MaverickUK/FDDSynthPro/docs/config.md

# The settings file

`/FDDSYNTH.CFG` on the SD card holds what the drive remembers across power-off, and how it sits on the cable. It's plain text, one `key=value` a line. The drive writes it a few seconds after you change the disk, the pack or the volume, so those three look after themselves. Edit the file on a computer to set the rest.

A damaged or missing file never stops the drive starting: an unknown line is ignored, and a bad value keeps the default.

```
last0=GAMES.IMG
pack=Recorded
volume=75
interface=ibmpc
cable=twisted
drive=a
```

| Key | Values | Default | |
|---|---|---|---|
| `device0` | a file name on the card | not set | **The disk to start with, every time.** Set it by hand; the drive never changes it. Not set, it starts with `last0` |
| `device1` | a file name on the card | not set | The same for the second drive, with two drives |
| `last0` | a file name on the card | the first | The disk that was in. The drive keeps this one up to date as you choose disks |
| `last1` | a file name on the card | the second | The second drive's, with two drives |
| `pack` | a folder under `/samples` | the first | The sample pack |
| `volume` | 0–100 | 75 | |
| `interface` | `ibmpc`, `shugart`, `amiga` | `ibmpc` | What the host expects on the cable |
| `cable` | `twisted`, `straight` | `twisted` | `ibmpc` only: is there a twist between the host and the drive? |
| `drive` | `a`, `b` or `a,b` (`ibmpc`); one or two of `ds0`, `ds1`, `ds2` (`shugart`); `df0`, `df1` or `df0,df1` (`amiga`) | `a` | Which drive this is: a real drive's select jumper. Two make it two drives |
| `pin02` | `nc`, `chg` | `nc` | `chg` drives DISK CHANGE on floppy pin 2 (Shugart and Amiga), after the carrier's rework ([wiring.md](wiring.md#pin-2-for-shugart-and-amiga-hosts-a-rework)) |

The drive reads `interface`, `cable` and `drive` at power-on. The console's `s` shows the ones in use.

**Changing a setting without taking the card out:** on the USB console, type `e`, then the setting (`interface=shugart`, or `device0 = GAMES.IMG`), then Enter. The drive writes it to the card at once, if the host isn't using the drive, and prints the file as it now is (`CONFIG` lines); a key it doesn't know, or a value it can't take, is refused and changes nothing. Then `!` restarts the drive with it. The drive's own `last0`, `pack` and `volume` follow the drive, as always.

**Drives count from 0**, as on HDDSynthPro (`device0`, `device1`) and on Shugart and Amiga cables (DS0, DF0): device 0 is the first drive `drive` names, device 1 the second. With `drive=a,b` they're A: and B:; with `drive=b` alone, device 0 is B:.

**Before 0.20.0** these were `image`, `image2`, `last` and `last2`. A file with the old names still works, and the drive writes them under the new names when it next saves. If a file has both, the new name counts.

## Two drives

`drive=a,b` (or two Shugart units, `drive=ds0,ds1`) makes the emulator both drives on the cable, each with its own disk, head and motor. With a PC that's A: and B:, and `COPY A:*.* B:` works as it would with two real drives. Each starts with its own disk (`device0`, `device1`) if set, else the disk that was in (`last0`, `last1`); with neither, the card's first two images.

- **The front panel** has a home screen for each, titled with its letter (`A: GAMES.IMG`). The action button goes from A's to B's, then on to the head trace. Choosing a disk, or a long press to eject, acts on the drive whose home screen was last shown.
- **The console's** `i`, `[`, `]` and `d` act on one drive: `1` or `2` chooses it. `s` reports the second drive's state with a `2` on each name (`cyl2`, `disk2`, `ready2`...).
- **The same image in both** is read-only in the second: two drives writing one file would each overwrite the other's changes.
- **The sound** is one mechanism: the motor runs while either drive's does, and you hear both drives' steps.
- Each drive keeps its own disk in PSRAM (1.44 MB each, of 8 MB) and its own cylinder buffer in RAM.

## Choosing the drive select

These do what the DS jumpers do on a real drive, and what the jumpers and FlashFloppy's `interface` setting do on a GoTek.

**An IBM PC** drives each drive on a pair of lines: select with motor. Drive A is on pins 14 and 10, drive B on 12 and 16. On a PC's cable the drive on the end connector, past the twist, sees A's lines on 12 and 16, so a PC drive is always jumpered for 12/16 and the cable decides whether it's A or B.

| Where the drive is | `cable` | `drive=a` answers on | `drive=b` answers on |
|---|---|---|---|
| Past the twist (the end of a PC cable) | `twisted` | 12 / 16 | 14 / 10 |
| No twist (a straight cable, or a PC cable's middle connector) | `straight` | 14 / 10 | 12 / 16 |

The rig's Feather host drives its drive A on 12 and 16, over a straight ribbon: the default (`twisted`, `a`) answers it. A Greaseweazle on a straight cable drives A on 14/10 and B on 12/16.

Pin 34 carries DISK CHANGE, and pin 2 is the host's density select, which the drive reads.

**A Shugart host** (the Atari ST, Amstrad CPC and PCW, many synths and samplers, most non-PC machines) has one select line per drive, DS0 to DS3, and one MOTOR ON line for all of them.

| `drive` | Select | Motor |
|---|---|---|
| `ds0` | pin 10 | pin 16 |
| `ds1` | pin 12 | pin 16 |
| `ds2` | pin 14 | pin 16 |

Pin 34 carries READY: asserted while the drive is selected, with a disk in and the motor at speed. DS3 (pin 6) isn't wired on the carrier.

A Shugart host also expects DISK CHANGE on pin 2. The carrier as built only reads pin 2, so hosts that need it see the disk change through READY instead. A small rework puts the SN7407's spare gate on pin 2 ([wiring.md](wiring.md#pin-2-for-shugart-and-amiga-hosts-a-rework)); then set `pin02=chg`.

## An Amiga

```
interface=amiga
drive=df0
pin02=chg
device0=Workbench1.3.adf
```

`interface=amiga` makes the drive an Amiga's: DF0 selects on pin 10, DF1 on pin 12 (`drive=df1`, or `df0,df1` for both). The drive serves `.adf` images (880 KB, AmigaDOS), and takes the Amiga's whole-track writes back into them.

- **The motor** line (pin 16) is latched as the drive is selected, as on a real Amiga drive, so DF0 and DF1 keep their own motors.
- **Pin 34** is /RDY: asserted once the motor is up to speed, and while the motor is off it gives the drive's ID: a standard 3.5-inch DD drive.
- **Pin 2** is /CHNG: how the Amiga notices a disk going in or out. It needs the carrier's rework and `pin02=chg`. Without it the Amiga reads whatever disk was in when it started, but never sees a swap.
- HD ADFs (1.76 MB) aren't served: an Amiga HD drive spins at 150 RPM, and its track is longer than the drive's buffers.

## Disk images and formats

The drive serves raw sector images (`.img`, `.ima`, and `.dsk` where `IMG.CFG` describes them) from the card's root folder. It works out each image's format in one of two ways.

**By its size,** for PC disks:

| Size | Disk | Cylinders | Sectors | Speed |
|---|---|---|---|---|
| 160 KB, 180 KB | 5.25-inch, single-sided | 40 | 8, 9 | 250 kbit/s, 300 RPM |
| 320 KB, 360 KB | 5.25-inch, double-sided | 40 | 8, 9 | 250 kbit/s, 300 RPM |
| 720 KB | 3.5-inch DD | 80 | 9 | 250 kbit/s, 300 RPM |
| 800 KB | 3.5-inch DD, 10 sectors | 80 | 10 | 250 kbit/s, 300 RPM |
| 1.2 MB | 5.25-inch HD | 80 | 15 | 500 kbit/s, 360 RPM |
| 1.44 MB | 3.5-inch HD | 80 | 18 | 500 kbit/s, 300 RPM |
| 1.68 MB | DMF (Microsoft's distribution format) | 80 | 21 | 500 kbit/s, 300 RPM |

These are Greaseweazle's `ibm.*` definitions. 2.88 MB disks aren't served: their 1 Mbit/s track is twice as long as the drive's buffers.

**From `IMG.CFG`,** for other machines' disks. This is FlashFloppy's geometry file, as the GoTek community writes it for Akai, Roland, Ensoniq, Kaypro and many more. Put it in the card's root, or in `/FF`. Each section describes the images it matches:

```
# 400 KB Kaypro disks: head 1's sectors are numbered on from head 0's.
[::409600]
cyls = 40
heads = 2
secs = 10
bps = 512
interleave = 3
h = 0
tracks = 0-39.0
  id = 0
tracks = 0-39.1
  id = 10
```

- **Matching:** a section `[tag::size]` matches images named `*.tag.img` of exactly that size. Leave either out: `[::409600]` matches by size alone, and `[roland]` any `*.roland.img`. An image with no matching section goes by its size.
- **Parameters:** the disk's `cyls`, `heads`, `step` and `file-layout`. Each track's `secs`, `bps`, `id`, `h`, `interleave`, `cskew`, `hskew`, `gap2`, `gap3`, `gap4a`, `iam`, `rate` and `rpm`. `tracks = ...` starts settings for some tracks only.
- **FM** (`mode = fm`, single density) works, on its own (the Osborne 1, the Spectrum's Sandy FDD2, BBC Micro DFS disks) or mixed with MFM: an FM boot track on an MFM disk (CompuPro, TSC Flex) can run at half the disk's rate.
- **A track a little too long** for a revolution (up to 5%, as some 8-inch CompuPro boot tracks are) makes the drive's revolution that much longer, as a GoTek does.
- **Not yet supported:** different sector sizes within one track (Ensoniq's Mirage), `img_bps` padding, tracks at rates other than the disk's or half of it, and a different speed on some tracks. A section that needs one is reported on the console when the card is read, and the image goes by its size instead.
- **Size:** images up to 2 MB are copied into PSRAM before they go in. A bigger one (Ensoniq's 5 MB SuperDisk) works, but its tracks are read from the card as the head moves, so seeks are slow.

## Flux images (HFE)

An `.hfe` file holds each track's cells as recorded, not its sectors. So it keeps what a sector image can't: copy protection's deliberately bad CRCs, sectors with the same ID, long tracks and weak bits, and disks this drive has no encoder for. Greaseweazle writes them (`gw read game.hfe`), as do the HxC tools, and FlashFloppy serves them on a GoTek.

- **What's served:** HFE v1 and v3, at the file's bit rate, one or two sides, single- or double-stepped. Every track is the length of the longest, and a revolution takes that long, so long-track protections keep their length.
- **Weak bits** (a protection that reads differently every time) go out as fresh random flux several times a revolution, as a real drive reads noise there.
- **Writes** are spliced into the track's cells and written back to the file at once, for v1 files. A v3 file is read-only: its opcodes don't map evenly onto cells.
- **Not yet:** a bit rate that changes along a track (Rob Northen's Copylock and the like). Those tracks are served at the disk's rate, and the console says how many there are when the image is opened: the protection fails, the rest of the disk works.
- **Size:** the whole file goes into PSRAM before the disk goes in. A DD disk is about 2 MB, an HD one 4 MB. With one drive both fit; with two, DD ones do, and an HD one is read from the card as the head moves (slow seeks).
