MaverickUK/FDDSynthPro/docs/oled/disks.png

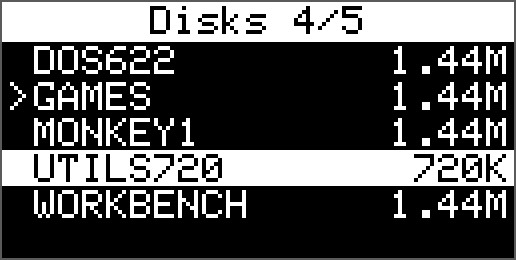
docs/oled/disks.png
