MaverickUK/FDDSynthPro/docs/oled/home_idle_write_protected.png

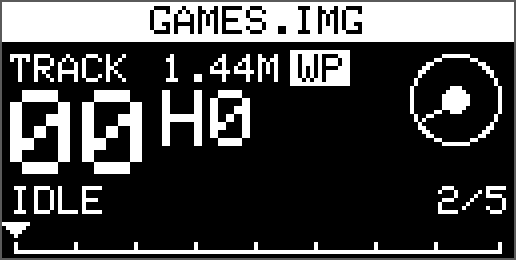
docs/oled/home_idle_write_protected.png
