MaverickUK/FDDSynthPro/docs/oled/home_no_disk.png

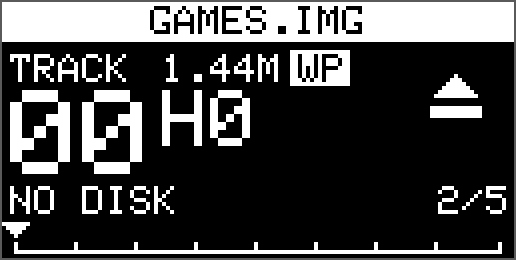
docs/oled/home_no_disk.png
