MaverickUK/FDDSynthPro/docs/oled/home_seeking.png

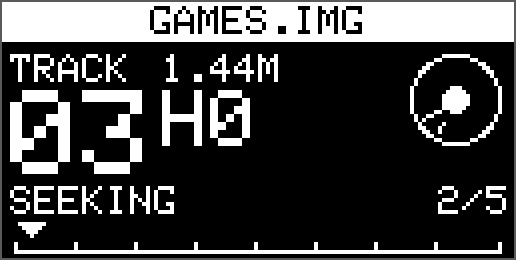
docs/oled/home_seeking.png
