MaverickUK/FDDSynthPro/docs/oled/home_writing.png

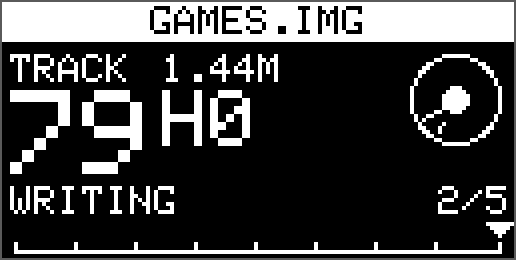
docs/oled/home_writing.png
