MaverickUK/FDDSynthPro/docs/oled/packs.png

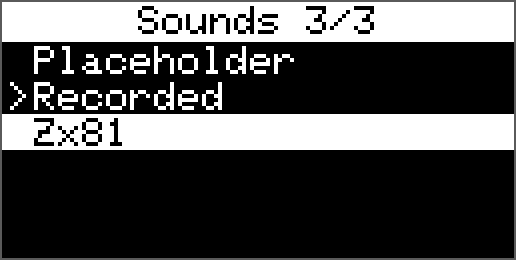
docs/oled/packs.png
