MaverickUK/FDDSynthPro/docs/oled/sounds.png

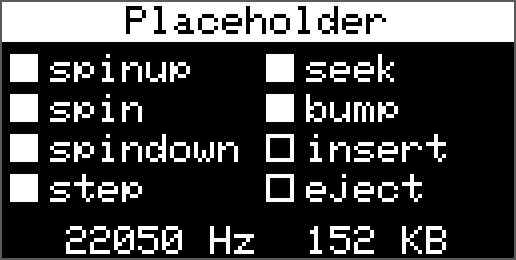
docs/oled/sounds.png
