MaverickUK/FDDSynthPro/docs/oled/sounds_loading.png

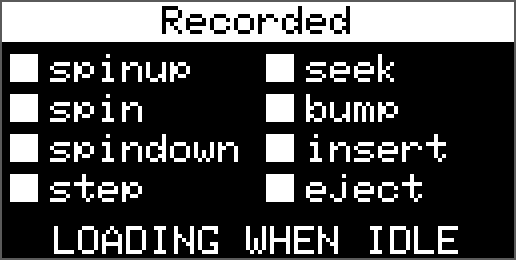
docs/oled/sounds_loading.png
