MaverickUK/FDDSynthPro/docs/oled/stats.png

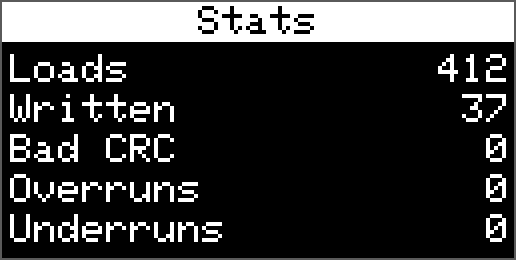
docs/oled/stats.png
