MaverickUK/FDDSynthPro/docs/oled/swap_ejecting.png

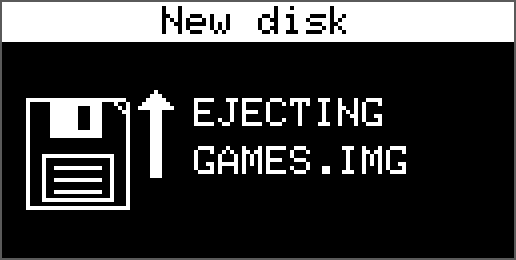
docs/oled/swap_ejecting.png
