MaverickUK/FDDSynthPro/docs/oled/swap_inserting.png

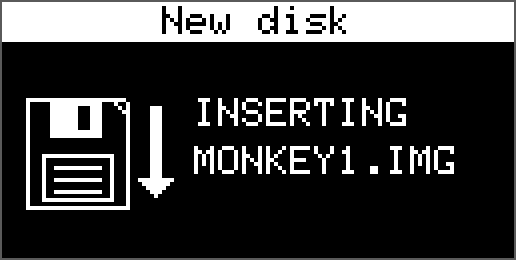
docs/oled/swap_inserting.png
