MaverickUK/FDDSynthPro/docs/oled/volume_75.png

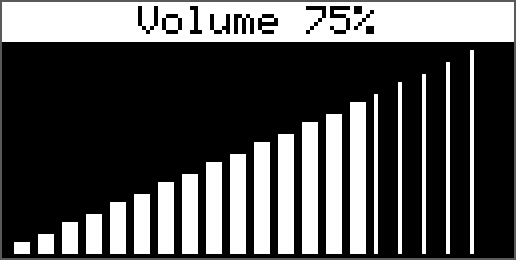
docs/oled/volume_75.png
