MaverickUK/FDDSynthPro/docs/wiring.html

FDDSynthPro · the drive · firmware 0.9 pin map · BB48R

# Olimex BB48R to a 34-pin floppy header

Ten inputs straight to the BB48R (GPIO 12–21), each pulled up by the SIP network; five outputs (GPIO 4–7 and 22) through the SN7407, which pulls the cable low for the board. The microSD card sits in the BB48R's own slot, so there's no SD wiring. The amp and the front panel hang off the other pins. Pick any pin or row to see its wire.

This map is for the BB48R

GPIO 8 (PSRAM select), 9–11 and 24 (the SD slot) belong to the board: leave EXT1-12 to 15 and EXT2-4 unwired. Firmware before 0.9 used the plain BB48's map and doesn't fit this wiring.

Power order

BB48R on (USB-C) before the host's USB; the host off first. The RP2350's pins are 5 V tolerant only while it is powered, and the FeatherWing's outputs are 5 V.

Odd pins are all ground

Pins 1–33 odd. Wire at least five, spread along the header, to the ground rail; all seventeen is better. Pins 4 and 6 stay unconnected.

One strip per header pin

The box header's two columns must not share a Perma-Proto strip: cut the trace between them under every row (see the board plan), then check with a meter that pins 1 and 2 aren't connected.

5 V only to the SN7407 and the amp

From the BB48R's VBUS (EXT2-1). The SIP network's common goes to +3.3V (EXT1-1), never 5 V.

Outputs straight to the header: FeatherWing bring-up only

Flash bb48_direct or bb48_drive_direct: they use the five output pins as open drain, so the host's pull-ups take the lines to 5 V. The ordinary builds drive them high and would fight the pull-ups. Measure each output line's pull-up first (bring-up step 3): 1 kΩ or more to 5 V is fine. Fit the SN7407 before connecting a real PC.

## Pin to pin

Show all wires Without the SN7407 (FeatherWing only)

Inputs (host → drive) Outputs, via the SN7407 Power Ground Amp Front panel The board's own: don't wire

Left: the floppy box header seen from above, pin 1 at the top, odd pins (all ground) in the left column. Middle: the SN7407, pin 1 at the top left. Right: the BB48R as in Olimex's pinout, USB-C at the top, EXT1 (GPIO 0–23) the left row, EXT2 (GPIO 24–47) the right. Dashed tags are pins the board uses itself. The "10k" marks are the SIP network's pull-ups to +3.3 V. Check it all against the silkscreens.

## Wiring checklist

Clear ticks

Done | From | Signal | To | GPIO | Notes

The ticks are saved in this browser only.

## On the Perma-Proto

A plan by zones, not hole by hole: check it against the real parts before soldering. Rows run along the board; each half-row (a–e, f–j) is one strip.

The amp, the speaker, the OLED (on a Qwiic cable to the BB48R's own socket) and the encoder and button sit off the board on short leads.

### Placing

- BB48R across the centre channel at the far end (rows 34–60), in female headers so it can be swapped. All fifteen floppy signals are on EXT1. Keep the microSD slot's end clear so the card can come out.
- Box header at the near end, on the left half, its two columns in holes c and d. Cut the trace between c and d under all 17 rows, so pin 1 and pin 2 (and every pair) are on separate strips.
- SIP network in a 1 × 11 socket on the right half of the header's rows, one pin per row, pin 1 (the dot) nearest the end. Pin 1 to +3.3V; pins 2–11 to the ten inputs.
- SN7407 in its socket across the centre channel, notch towards the header, with 100 nF between pins 14 and 7.
- No SD breakout: the card goes in the BB48R's own slot. Rows 27–33 stay free.

### First power-up check

With the host connected and reset (python -m fddproto.gw_reset --device <port> in host/), type p in the serial monitor:

PINS DENSEL=OFF MOTEA=OFF DRVSB=OFF DRVSA=OFF MOTEB=OFF DIR=OFF STEP=OFF WDATA=OFF WGATE=OFF SIDE1=OFF
- Every input OFF (high, on its pull-up). DENSEL may be either: it's a level, not a request.
- An input stuck ON usually means a wire on the wrong pin, or the SIP in backwards.
- Run the solder-bridge test first, cable unplugged: x then Y.
