MaverickUK/FDDSynthPro/hardware/fddsynthpro_carrier.kicad_pcb

## KiCad design hardware/fddsynthpro_carrier.kicad_pcb (2026-10-27)

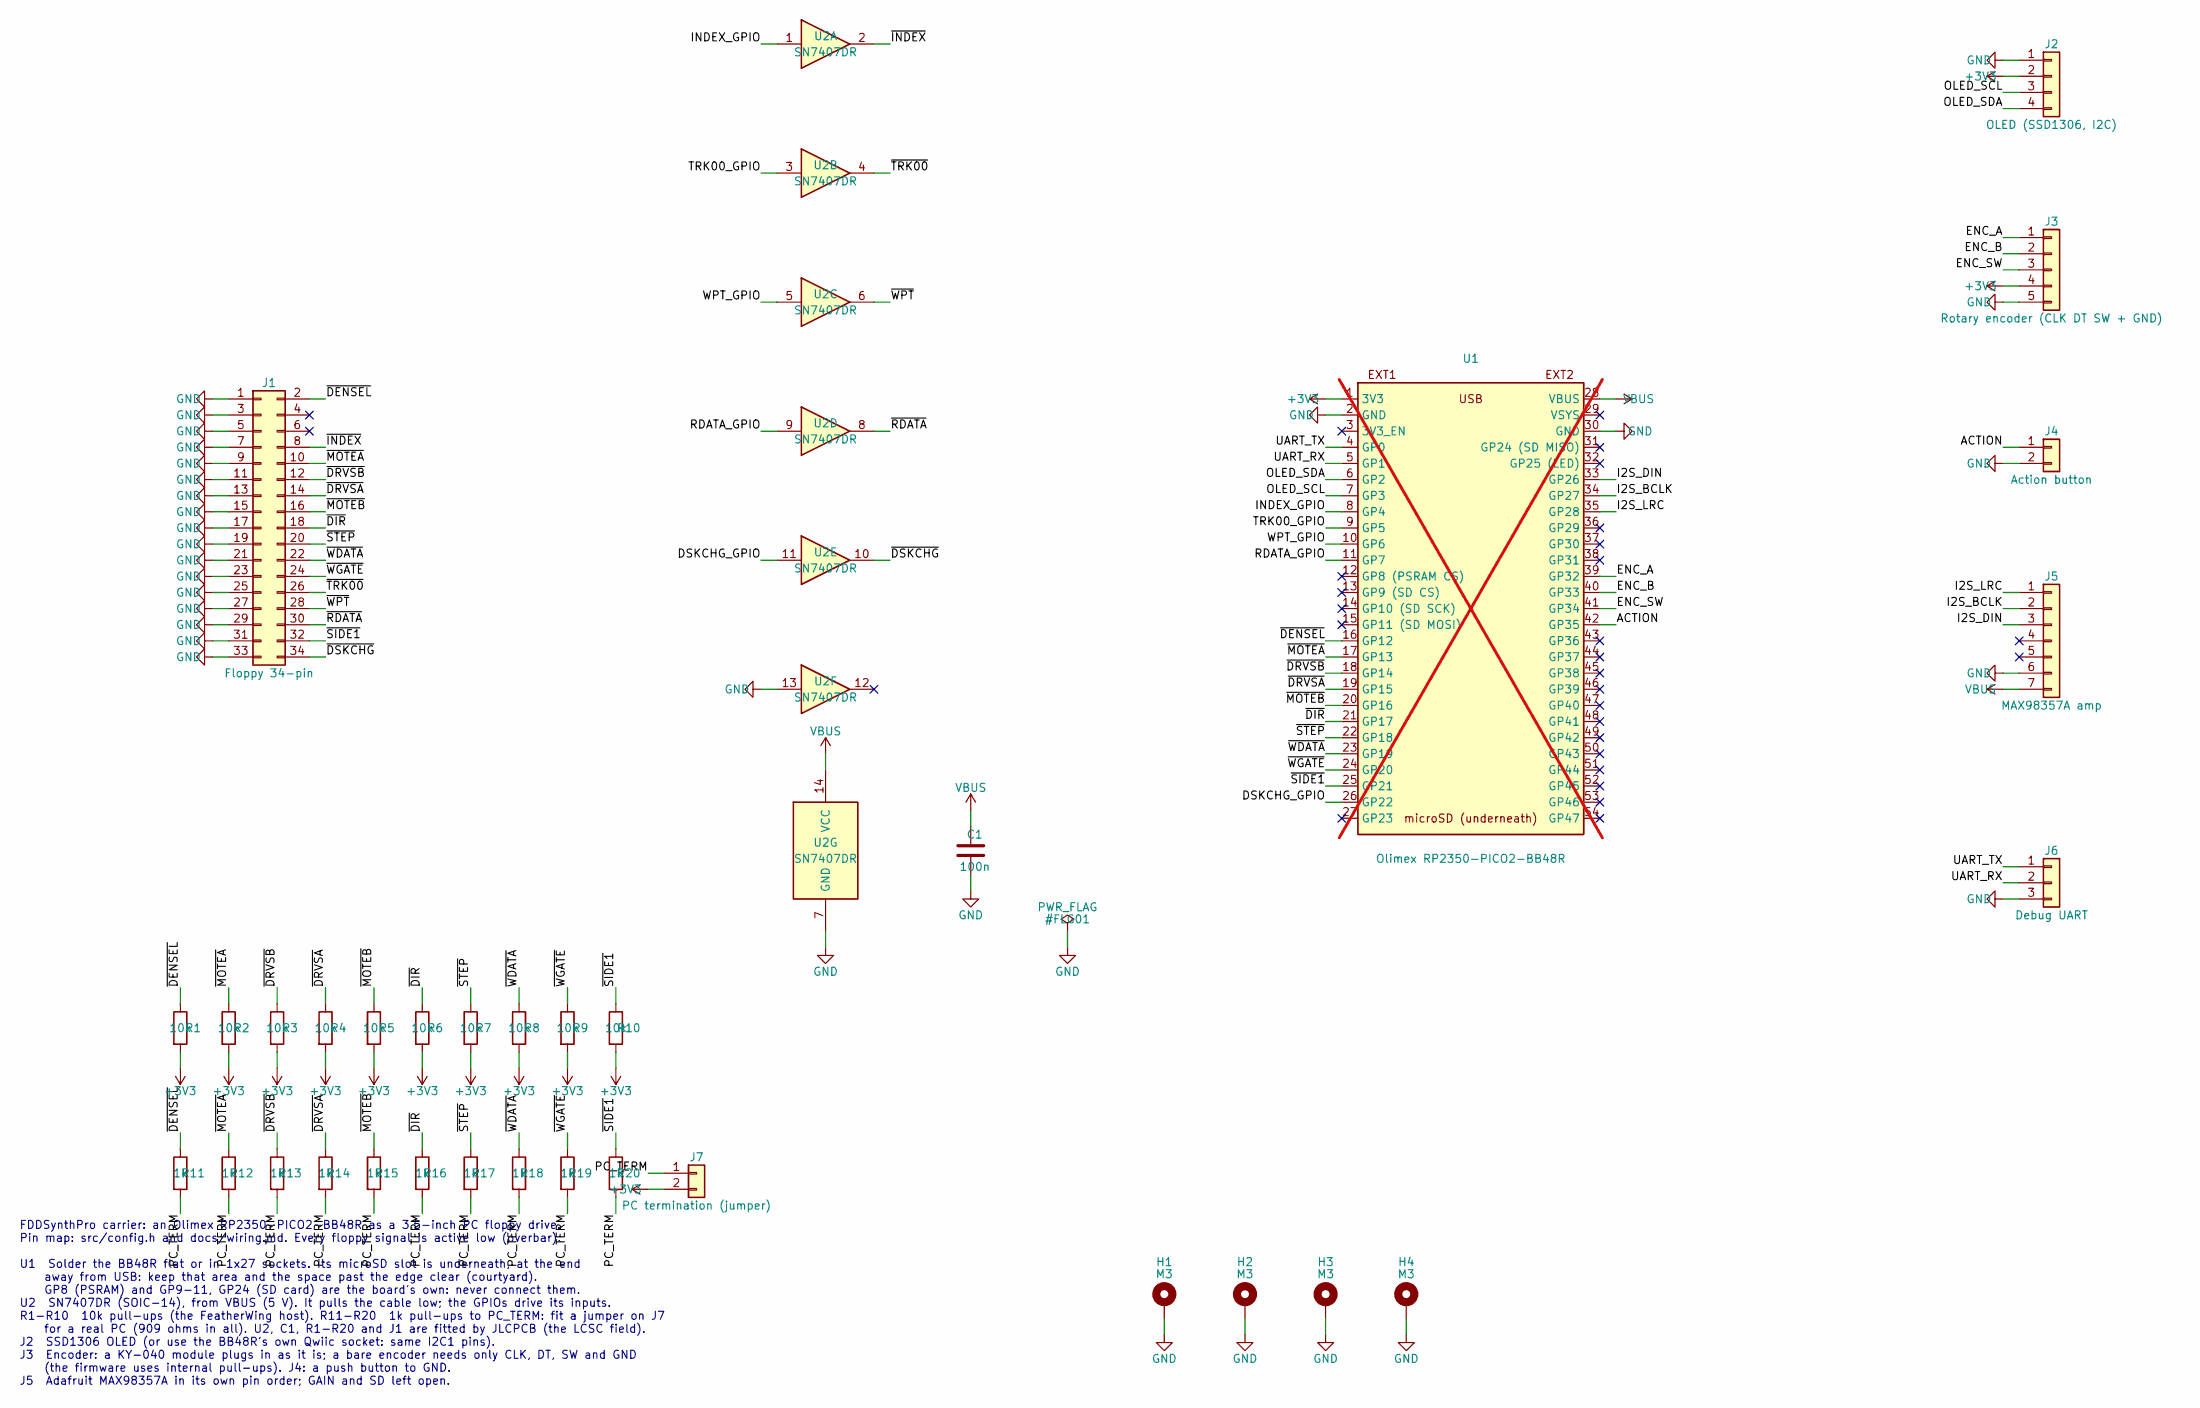
[picture p18: schematic fddsynthpro_carrier.kicad_sch, FDDSynthPro carrier: BB48R floppy drive]

Parts:
C1: 100n; C_0603_1608Metric; LCSC Part Number C14663
H1, H2, H3, H4: M3; MountingHole_3.2mm_M3_Pad
J1: Floppy 34-pin; IDC-Header_2x17_P2.54mm_Vertical; LCSC Part Number C9042
J2: OLED (SSD1306, I2C); PinHeader_1x04_P2.54mm_Vertical; LCSC Part Number C124378
J3: Rotary encoder (CLK DT SW + GND); PinHeader_1x05_P2.54mm_Vertical; LCSC Part Number C124379
J4: Action button; PinHeader_1x02_P2.54mm_Vertical; LCSC Part Number C124375
J5: MAX98357A amp; PinHeader_1x07_P2.54mm_Vertical; LCSC Part Number C492406
J6: Debug UART; PinHeader_1x03_P2.54mm_Vertical; LCSC Part Number C124376
J7: PC termination (jumper); PinHeader_1x02_P2.54mm_Vertical; LCSC Part Number C124375
R1, R2, R3, R4, R5, R6, R7, R8, R9, R10: 10k; R_0402_1005Metric; LCSC Part Number C25744
R11, R12, R13, R14, R15, R16, R17, R18, R19, R20: 1k; R_0402_1005Metric; LCSC Part Number C11702
U1: Olimex RP2350-PICO2-BB48R; Olimex_RP2350-PICO2-BB48; not fitted
U2: SN7407DR; SOIC-14_3.9x8.7mm_P1.27mm; LCSC Part Number C40481

Connections:
+3V3: J2.2, J3.4, J7.2, R1.2, R2.2, R3.2, R4.2, R5.2, R6.2, R7.2, R8.2, R9.2, R10.2, U1.1 (3V3)
/ACTION: J4.1, U1.42 (GP35)
/DSKCHG_GPIO: U1.26 (GP22), U2.11
/ENC_A: J3.1, U1.39 (GP32)
/ENC_B: J3.2, U1.40 (GP33)
/ENC_SW: J3.3, U1.41 (GP34)
/I2S_BCLK: J5.2, U1.34 (GP27)
/I2S_DIN: J5.3, U1.33 (GP26)
/I2S_LRC: J5.1, U1.35 (GP28)
/INDEX_GPIO: U1.8 (GP4), U2.1
/OLED_SCL: J2.3, U1.7 (GP3)
/OLED_SDA: J2.4, U1.6 (GP2)
/PC_TERM: J7.1, R11.2, R12.2, R13.2, R14.2, R15.2, R16.2, R17.2, R18.2, R19.2, R20.2
/RDATA_GPIO: U1.11 (GP7), U2.9
/TRK00_GPIO: U1.9 (GP5), U2.3
/UART_RX: J6.2, U1.5 (GP1)
/UART_TX: J6.1, U1.4 (GP0)
/WPT_GPIO: U1.10 (GP6), U2.5
/~DENSEL: J1.2, R1.1, R11.1, U1.16 (GP12)
/~DIR: J1.18, R6.1, R16.1, U1.21 (GP17)
/~DRVSA: J1.14, R4.1, R14.1, U1.19 (GP15)
/~DRVSB: J1.12, R3.1, R13.1, U1.18 (GP14)
/~DSKCHG: J1.34, U2.10
/~INDEX: J1.8, U2.2
/~MOTEA: J1.10, R2.1, R12.1, U1.17 (GP13)
/~MOTEB: J1.16, R5.1, R15.1, U1.20 (GP16)
/~RDATA: J1.30, U2.8
/~SIDE1: J1.32, R10.1, R20.1, U1.25 (GP21)
/~STEP: J1.20, R7.1, R17.1, U1.22 (GP18)
/~TRK00: J1.26, U2.4
/~WDATA: J1.22, R8.1, R18.1, U1.23 (GP19)
/~WGATE: J1.24, R9.1, R19.1, U1.24 (GP20)
/~WPT: J1.28, U2.6
GND: C1.2, H1.1, H2.1, H3.1, H4.1, J1.1, J1.3, J1.5, J1.7, J1.9, J1.11, J1.13, J1.15, J1.17, J1.19, J1.21, J1.23, J1.25, J1.27, J1.29, J1.31, J1.33, J2.1, J3.5, J4.2, J5.6, J6.3, U1.2 (GND), U1.30 (GND), U2.7 (GND), U2.13
VBUS: C1.1, J5.7, U1.28 (VBUS), U2.14 (VCC)

Notes on the sheet:
FDDSynthPro carrier: an Olimex RP2350-PICO2-BB48R as a 3.5-inch PC floppy drive. Pin map: src/config.h and docs/wiring.md. Every floppy signal is active low (overbar). U1 Solder the BB48R flat or in 1x27 sockets. Its microSD slot is underneath, at the end away from USB: keep that area and the space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

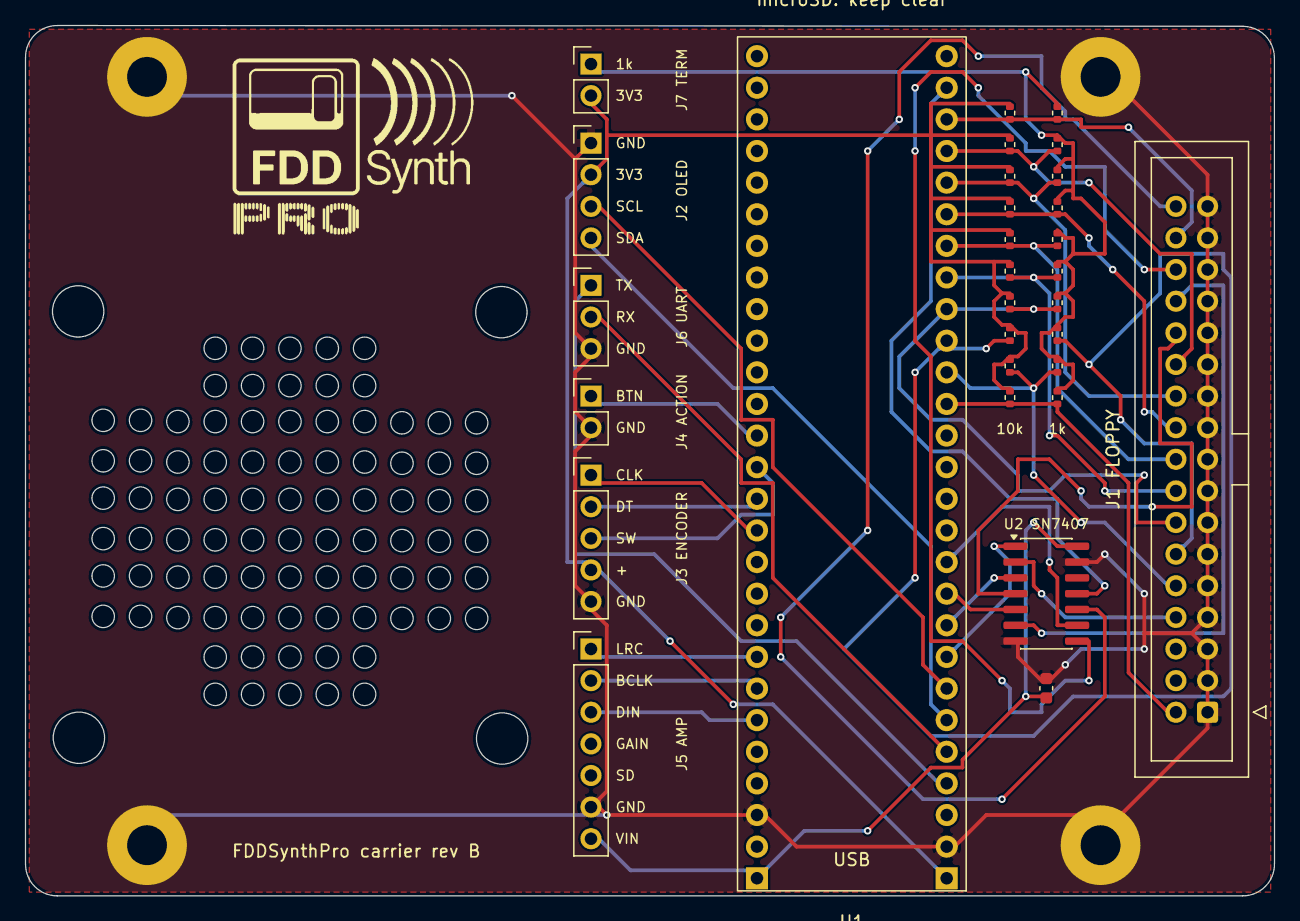
[picture p19: board fddsynthpro_carrier.kicad_pcb from above]

Board: 2 copper layers, 100.3 x 69.9 mm, 34 parts (0 on the bottom side), 35 nets.
