MaverickUK/FDDSynthPro/src/splash_logo.h

// The logo the OLED shows at power-on: 128 x 64, a row of 16 bytes per
// line, the leftmost pixel in the top bit, 1 = lit. Generated from
// media/FDDSynthPro.png by scripts/make_splash.py: run that, don't edit this.
#pragma once

#include <cstdint>

namespace splash {

constexpr int WIDTH = 128, HEIGHT = 64;
constexpr uint8_t LOGO[64][16] = {
    {0x00, 0x00, 0x03, 0xFF, 0xFF, 0xFF, 0xFF, 0xFF, 0x01, 0x02, 0x00, 0x08, 0x00, 0x00, 0x00, 0x00},
    {0x00, 0x00, 0x0F, 0xFF, 0xFF, 0xFF, 0xFF, 0xFF, 0x81, 0x83, 0x0E, 0x0C, 0x18, 0x00, 0x00, 0x00},
    {0x00, 0x00, 0x08, 0x00, 0x00, 0x00, 0x00, 0x00, 0xC3, 0xC3, 0x87, 0x02, 0x0C, 0x00, 0x00, 0x00},
    {0x00, 0x00, 0x08, 0x00, 0x00, 0x00, 0x00, 0x00, 0x41, 0xE0, 0xC1, 0x81, 0x06, 0x00, 0x00, 0x00},
    {0x00, 0x00, 0x08, 0x1F, 0xFF, 0xFF, 0xFF, 0xE0, 0x40, 0x70, 0x60, 0xC0, 0x82, 0x00, 0x00, 0x00},
    {0x00, 0x00, 0x08, 0x20, 0x00, 0x00, 0x00, 0x10, 0x40, 0x38, 0x30, 0xC0, 0xC1, 0x00, 0x00, 0x00},
    {0x00, 0x00, 0x08, 0x20, 0x00, 0x00, 0x3F, 0x10, 0x40, 0x38, 0x30, 0x60, 0x40, 0x80, 0x00, 0x00},
    {0x00, 0x00, 0x08, 0x20, 0x00, 0x00, 0x40, 0x90, 0x40, 0x1C, 0x18, 0x20, 0x20, 0x80, 0x00, 0x00},
    {0x00, 0x00, 0x08, 0x20, 0x00, 0x00, 0x00, 0x50, 0x40, 0x0C, 0x18, 0x30, 0x20, 0x40, 0x00, 0x00},
    {0x00, 0x00, 0x08, 0x20, 0x00, 0x00, 0x80, 0x50, 0x40, 0x0E, 0x0C, 0x10, 0x30, 0x40, 0x00, 0x00},
    {0x00, 0x00, 0x08, 0x20, 0x00, 0x00, 0x80, 0x50, 0x40, 0x0E, 0x0C, 0x18, 0x10, 0x00, 0x00, 0x00},
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
    {0x00, 0x00, 0x08, 0x1C, 0x06, 0x06, 0x60, 0x60, 0x43, 0x02, 0x1B, 0x19, 0x18, 0xC0, 0x00, 0x00},
    {0x00, 0x00, 0x08, 0x1F, 0xE6, 0x06, 0x60, 0x60, 0x41, 0xE3, 0x12, 0x19, 0x10, 0x40, 0x00, 0x00},
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
};

}  // namespace splash
