MaverickUK/FDDSynthPro/src/settings.h

// What the drive remembers across power-off, GoTek style: the disk that was
// in, the sample pack and the volume; and what only an edit of the file
// changes: a disk to start with every time, and how the drive sits on the
// cable (bus.h). Pure C++, host-tested; sd_image.cpp reads and writes the
// file, main.cpp decides when.
//
// The file is /FDDSYNTH.CFG on the card, plain text, one setting a line
// (docs/config.md):
//
//   device0=GAMES.IMG    (if set: the disk at every power-on; else last0's)
//   last0=MONKEY1.IMG    the disk that was in (the firmware keeps this one)
//   last1=WORK.IMG       (the second drive's, with drive=a,b; device1 likewise)
//
// Drives count from 0, as HDDSynthPro's device0/device1 and Shugart's DS0:
// device0 is the first drive `drive` names. Before 0.20.0 the keys were
// image, image2, last and last2; they're still read, and written back under
// the new names.
//   pack=Recorded
//   volume=75
//   interface=ibmpc
//   cable=twisted
//   drive=a
//
// By name, not position, so adding files to the card doesn't change which
// disk comes back. Unknown lines are ignored and a bad value keeps the
// default, so a hand-edited file never stops the drive starting.
#pragma once

#include <cstddef>
#include <cstdint>

#include "bus.h"

namespace settings {

constexpr const char* PATH = "/FDDSYNTH.CFG";
constexpr size_t NAME = 64;  // as ImageList::NAME
// Room for a file with notes in it (the welcome disk's sample is 1 KB);
// the drive's own, without notes, is under 512 bytes. A longer file is read
// as far as this.
constexpr size_t FILE_MAX = 4096;

struct Settings {
    // Each drive's disk at power-on (`device0`, `device1`), if set: by hand
    // only, never by the firmware. "": the last one (`last0`, `last1`),
    // else the card's first.
    char image[bus::MAX_DRIVES][NAME] = {};
    char last[bus::MAX_DRIVES][NAME] = {};  // each drive's disk when it was last in use
    char pack[NAME] = "";   // "": the first folder under /samples
    int volume = 75;        // 0-100, ui::Model's
    bus::Setup bus;         // read at power-on

    bool operator==(const Settings& o) const;
    bool operator!=(const Settings& o) const { return !(*this == o); }
};

// Reads the file's text into `out`, starting from the defaults.
Settings parse(const char* text, size_t len);
// The file's text; returns its length (less than `cap`).
size_t format(const Settings& s, char* out, size_t cap);
// One setting, as the console's `e` takes it: "key=value" ("key = value"
// too). Returns false, leaving `s` as it was, for an unknown key or a value
// it can't take. An old name (image, last...) sets the new one.
bool set(Settings& s, const char* line, size_t len);

// When to write a change to the card: once nothing has changed for
// SETTLE_MS (a turn of the volume is many changes) and the drive is idle
// (the host has it deselected and no swap or write is under way), so the
// write never holds up the host.
class SaveTimer {
public:
    static constexpr uint32_t SETTLE_MS = 3000;

    void changed(uint32_t now_ms) {
        dirty_ = true;
        changed_ms_ = now_ms;
    }
    bool due(uint32_t now_ms, bool drive_idle) const {
        return dirty_ && drive_idle && now_ms - changed_ms_ >= SETTLE_MS;
    }
    void saved() { dirty_ = false; }
    bool dirty() const { return dirty_; }

private:
    bool dirty_ = false;
    uint32_t changed_ms_ = 0;
};

}  // namespace settings
