MaverickUK/FDDSynthPro/src/wdata_pio.cpp

#include "wdata_pio.h"

#include <hardware/clocks.h>
#include <hardware/dma.h>
#include <hardware/pio.h>

#include <initializer_list>

#include "config.h"
#include "fdd_wdata.pio.h"
#include "rdata_stream.h"

namespace wdata_pio {

static PIO s_pio;
static uint s_sm;
static uint s_offset;
static int s_dma;
static uint8_t* s_ring;
static uint32_t s_mask;
static uint32_t s_last_offset = 0;
static uint32_t s_produced = 0;

void begin(uint8_t* ring, uint32_t ring_bytes, uint32_t data_rate_bps) {
    s_ring = ring;
    s_mask = ring_bytes - 1;
    // PIO 2 or 1, as for RDATA.
    bool ok = false;
    for (PIO p : {pio2, pio1}) {
        int sm = pio_claim_unused_sm(p, false);
        if (sm < 0) continue;
        if (pio_get_gpio_base(p) == 0 && pio_can_add_program(p, &fdd_wdata_program)) {
            s_pio = p;
            s_sm = uint(sm);
            s_offset = pio_add_program(p, &fdd_wdata_program);
            ok = true;
            break;
        }
        pio_sm_unclaim(p, uint(sm));
    }
    hard_assert(ok);

    pio_sm_config c = fdd_wdata_program_get_default_config(s_offset);
    sm_config_set_jmp_pin(&c, cfg::PIN_WDATA);  // read only: WDATA stays an SIO input
    sm_config_set_in_shift(&c, true, true, 32);  // first interval in the low byte, autopush
    sm_config_set_fifo_join(&c, PIO_FIFO_JOIN_RX);
    rdata::Divider div = rdata::clockDivider(clock_get_hz(clk_sys), data_rate_bps,
                                             fdd_wdata_TICKS_PER_CELL * 2);
    sm_config_set_clkdiv_int_frac8(&c, div.integer, div.frac);
    pio_sm_init(s_pio, s_sm, s_offset, &c);

    // An endless DMA round the ring: it only moves when the program pushes.
    s_dma = dma_claim_unused_channel(true);
    dma_channel_config d = dma_channel_get_default_config(s_dma);
    channel_config_set_transfer_data_size(&d, DMA_SIZE_32);
    channel_config_set_read_increment(&d, false);
    channel_config_set_write_increment(&d, true);
    channel_config_set_ring(&d, true, uint(__builtin_ctz(ring_bytes)));  // wrap the write address
    channel_config_set_dreq(&d, pio_get_dreq(s_pio, s_sm, false));
    dma_channel_configure(s_dma, &d, ring, &s_pio->rxf[s_sm], dma_encode_endless_transfer_count(), true);
}

void setRate(uint32_t data_rate_bps) {
    rdata::Divider div = rdata::clockDivider(clock_get_hz(clk_sys), data_rate_bps, fdd_wdata_TICKS_PER_CELL * 2);
    pio_sm_set_clkdiv_int_frac8(s_pio, s_sm, div.integer, div.frac);
}

void start() {
    pio_sm_restart(s_pio, s_sm);  // empties the shift register: whole words only
    pio_sm_exec(s_pio, s_sm, pio_encode_jmp(s_offset + fdd_wdata_offset_start));
    pio_sm_set_enabled(s_pio, s_sm, true);
}

void stop() {
    pio_sm_set_enabled(s_pio, s_sm, false);
    while (!pio_sm_is_rx_fifo_empty(s_pio, s_sm)) tight_loop_contents();  // the DMA takes the rest
}

uint32_t produced() {
    uint32_t offset = (uint32_t(dma_hw->ch[s_dma].write_addr) - uint32_t(uintptr_t(s_ring))) & s_mask;
    s_produced += (offset - s_last_offset) & s_mask;
    s_last_offset = offset;
    return s_produced;
}

uint32_t edgeTicks() { return fdd_wdata_EDGE_TICKS; }
uint32_t ticksPerCell() { return fdd_wdata_TICKS_PER_CELL; }

}  // namespace wdata_pio
