MaverickUK/FDDSynthPro/src/version.h

#pragma once

// SemVer. Bump in the same commit as any firmware change (see CLAUDE.md).
#define FIRMWARE_VERSION "0.24.0"

// What this build does, set per environment in platformio.ini:
//   0  listen only (slice 0): every pin an input, traces what the host does
//   5  the drive (slices 1-5): head, index, TRK00, WPT, DSKCHG, RDATA from
//      an image on the SD card (or the generated 1.44 MB disk), writes back
//      to the image, and the sound events (ACT lines)
#ifndef FIRMWARE_SLICE
#define FIRMWARE_SLICE 0
#endif
