MaverickUK/FDDSynthPro/src/fdd_signals.h

// Decoding a pin sample of the floppy interface. Pure C++, host-tested.
//
// A sample is the GPIO levels shifted so bit n is GPIO (BUS_FIRST_PIN + n):
// `gpio_get_all() >> cfg::BUS_FIRST_PIN`. Every floppy line is active low,
// so a signal is asserted ("ON") when its bit is 0.
#pragma once

#include <cstdint>

#include "config.h"

namespace fdd {

constexpr unsigned bitOf(unsigned pin) { return pin - cfg::BUS_FIRST_PIN; }
constexpr uint32_t maskOf(unsigned pin) { return 1u << bitOf(pin); }
constexpr bool high(uint32_t sample, unsigned pin) { return (sample >> bitOf(pin)) & 1u; }
constexpr bool asserted(uint32_t sample, unsigned pin) { return !high(sample, pin); }

constexpr uint32_t rangeMask(unsigned first, unsigned last) {
    return ((last - first + 1 >= 32) ? ~0u : ((1u << (last - first + 1)) - 1u)) << bitOf(first);
}

constexpr uint32_t outputMask() {
    uint32_t m = 0;
    for (unsigned pin : cfg::OUTPUT_PINS) m |= maskOf(pin);
    return m;
}

constexpr uint32_t INPUT_MASK = rangeMask(cfg::FIRST_INPUT_PIN, cfg::LAST_INPUT_PIN);
constexpr uint32_t OUTPUT_MASK = outputMask();  // not consecutive: GPIO 4-7 and 22-23

// The inputs the listener records changes on. WDATA is left out: during a
// write it toggles every few microseconds, which would flood the trace.
// STEP is recorded as its own event (one per assertion), not as a change.
constexpr uint32_t WATCHED_MASK = INPUT_MASK & ~maskOf(cfg::PIN_WDATA);

// A host that's switched off holds every line low through its chips'
// protection diodes: all the inputs asserted at once, which no running host
// does (both selects, both motors, WGATE and STEP together). The drive then
// takes the lines as released, so it doesn't spin and click by itself while
// the computer is off and the drive is on USB (0.23.9).
constexpr bool hostOff(uint32_t sample) { return (sample & INPUT_MASK) == 0; }

// Short name of a floppy line ("?" for a pin that isn't one).
const char* signalName(unsigned pin);

}  // namespace fdd
