MaverickUK/FDDSynthPro/src/mfm_decode.cpp

#include "mfm_decode.h"

namespace mfm {

// An FM mark's cells: its data bits with clock C7.
static constexpr uint16_t fmMark(uint8_t mark) {
    uint16_t w = 0;
    for (int i = 7; i >= 0; --i) w = uint16_t(w << 2 | ((0xC7 >> i) & 1) << 1 | ((mark >> i) & 1));
    return w;
}

void FieldScanner::reset(uint16_t default_data_len, bool fm) {
    fm_ = fm;
    default_len_ = next_len_ = default_data_len;
    state_ = State::Hunting;
    cells_ = shift_ = 0;
    word_bits_ = syncs_ = 0;
    store_pos_ = count_ = 0;
    overflowed_ = 0;
}

void FieldScanner::startField(uint8_t mark) {
    current_ = Field{};
    current_.mark = mark;
    current_.cell = sync_cell_;
    crc_ = crc16::INITIAL;
    if (!fm_)
        for (int i = 0; i < 3; ++i) crc_ = crc16::update(crc_, 0xA1);
    crc_ = crc16::update(crc_, mark);
    body_pos_ = 0;
    if (mark == MARK_IDAM) {
        body_len_ = 6;
    } else {
        body_len_ = size_t(next_len_) + 2;
        if (store_pos_ + next_len_ > store_len_) {
            ++overflowed_;
            state_ = State::Hunting;
            return;
        }
        current_.data_offset = uint32_t(store_pos_);
        current_.data_len = next_len_;
    }
    state_ = State::Body;
}

void FieldScanner::finishField() {
    current_.crc_ok = crc_ == 0;  // the CRC over the field and its own CRC is 0
    if (current_.mark == MARK_IDAM) {
        for (int i = 0; i < 4; ++i) current_.id[i] = header_[i];
        // The data field that follows has the size this ID gives.
        next_len_ = current_.crc_ok && header_[3] <= 3 ? uint16_t(128u << header_[3]) : default_len_;
    } else {
        store_pos_ += current_.data_len;
        next_len_ = default_len_;
    }
    if (count_ < max_fields_)
        fields_[count_++] = current_;
    else
        ++overflowed_;
    state_ = State::Hunting;
}

void FieldScanner::addCell(bool one) {
    shift_ = (shift_ << 1) | (one ? 1u : 0u);
    ++cells_;

    if (state_ == State::Hunting) {
        if (fm_) {
            uint16_t w = uint16_t(shift_);
            if (w == fmMark(MARK_IDAM) || w == fmMark(MARK_DAM) || w == fmMark(MARK_DDAM)) {
                sync_cell_ = cells_ - 16;
                word_bits_ = 0;
                startField(decodeWord(w));  // the body follows, word-aligned
            }
            return;
        }
        huntSync();
        return;
    }

    // Aligned to whole words from here on.
    if (++word_bits_ < 16) return;
    word_bits_ = 0;
    takeWord(uint16_t(shift_));
}

void FieldScanner::takeSyncWord(uint16_t word) {
    if (word == SYNC_A1) {
        ++syncs_;
    } else if (syncs_ >= 3) {
        uint8_t mark = decodeWord(word);
        if (mark == MARK_IDAM || mark == MARK_DAM || mark == MARK_DDAM)
            startField(mark);
        else
            state_ = State::Hunting;
    } else {
        state_ = State::Hunting;
    }
}

}  // namespace mfm
