MaverickUK/FDDSynthPro/hardware/mk5_outline.py

"""The HDD Synth MK5's board outline, speaker holes and speaker grille,
copied from MaverickUK/HDDSynth 2_prototype_mk5/hardware/HDD Synth Prototype MK5.kicad_pcb
(its Edge.Cuts layer), in mm from the board's top-left corner (73.66, 46.925871 there).
The FDD Synth carrier uses the same shape and holes so it fits the same case."""

# Straight edges: (start, end).
LINES = [
    ((0.0, 2.604129), (0.0, 67.374129)),
    ((2.54, 0.0), (97.79, 0.064129)),
    ((2.540159, 69.914216), (97.79, 69.914129)),
    ((100.33, 67.309999), (100.326665, 2.604129)),
]

# Rounded corners: (start, mid, end).
ARCS = [
    ((0.0, 2.604129), (0.721135, 0.766716), (2.54, 0.0)),
    ((2.540159, 69.914216), (0.744, 69.170267), (0.0, 67.374129)),
    ((97.79, 0.064129), (99.583855, 0.809279), (100.326665, 2.604129)),
    ((100.33, 67.309999), (99.608893, 69.147438), (97.79, 69.914129)),
]

# Holes cut through the board: (x, y, radius). Four 4.1 mm speaker-mounting
# holes and the grille's 1.8 mm holes.
HOLES = [
    (4.226894, 22.964129, 2.061553),
    (4.288447, 57.214129, 2.061553),
    (6.24, 31.715517, 0.901388),
    (6.24, 34.965517, 0.901388),
    (6.24, 37.965517, 0.901388),
    (6.24, 41.215517, 0.901388),
    (6.24, 44.215517, 0.901388),
    (6.24, 47.465517, 0.901388),
    (9.24, 31.715517, 0.901388),
    (9.24, 34.965517, 0.901388),
    (9.24, 37.965517, 0.901388),
    (9.24, 41.215517, 0.901388),
    (9.24, 44.215517, 0.901388),
    (9.24, 47.465517, 0.901388),
    (12.24, 31.814129, 0.901388),
    (12.24, 35.064129, 0.901388),
    (12.24, 38.064129, 0.901388),
    (12.24, 41.314129, 0.901388),
    (12.24, 44.314129, 0.901388),
    (12.24, 47.564129, 0.901388),
    (15.24, 25.92707, 0.901388),
    (15.24, 28.92707, 0.901388),
    (15.24, 31.814129, 0.901388),
    (15.24, 35.064129, 0.901388),
    (15.24, 38.064129, 0.901388),
    (15.24, 41.314129, 0.901388),
    (15.24, 44.314129, 0.901388),
    (15.24, 47.564129, 0.901388),
    (15.24, 50.72707, 0.901388),
    (15.24, 53.72707, 0.901388),
    (18.24, 25.92707, 0.901388),
    (18.24, 28.92707, 0.901388),
    (18.24, 31.814129, 0.901388),
    (18.24, 35.064129, 0.901388),
    (18.24, 38.064129, 0.901388),
    (18.24, 41.314129, 0.901388),
    (18.24, 44.314129, 0.901388),
    (18.24, 47.564129, 0.901388),
    (18.24, 50.72707, 0.901388),
    (18.24, 53.72707, 0.901388),
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
]

# The M3 mounting holes (MountingHole_3.2mm_M3_Pad, grounded), as on the MK5.
MOUNTING_HOLES = [(9.76, 4.124129), (86.36, 4.124129), (9.76, 65.844129), (86.36, 65.844129)]
