MaverickUK/FDDSynthPro/scripts/make_drive_pack.py

#!/usr/bin/env python3
"""Cuts a sample pack from a session recorded by scripts/record_drive.py:
its recording.wav and session.jsonl (when each action ran).

    scripts/make_drive_pack.py host/runs/<time>-drive                 # writes samples/Drive/
    scripts/make_drive_pack.py RUN --name Mitsumi --audition out.wav
    scripts/make_drive_pack.py RUN --recording phone.m4a              # recorded some other way

How it finds each sound:
  - Clicks are found in the recording's high frequencies (a second
    difference), in 1 ms blocks, against the room's noise: an onset is a
    block over the threshold after 10 ms under it.
  - The recording and the log start at different moments (the mic opens
    late, or was started by hand). The offset is the one that puts the most
    clicks inside the logged actions and the fewest inside the pauses.
  - step: the median-loudness single step (step_in and step_out, at several
    cylinders). seek: a loop of steps from the longest seek, at the host's
    measured step rate. bump: a step past the outer stop, if the firmware
    did one. spinup, spin (whole revolutions, looped), spindown: from the
    long reads. insert, eject: the median-loudness one of each prompt.
  - Every seek is also saved whole under the run's extras/ folder, with the
    measured step rate, for seek sounds that follow the rate (not in the
    pack yet).

One gain for the pack, as make_recorded_pack.py: a step 6 dB under full
scale and nothing but the bump over the peak; the bump alone to the peak.
The pack must fit the firmware's 160 KB sample pool: the spin-down is
shortened first if it doesn't. Needs ffmpeg (to decode the recording).
"""
from __future__ import annotations

import argparse
import json
import math
import statistics
import sys
from bisect import bisect_left
from operator import mul, sub
from dataclasses import dataclass
from pathlib import Path

REPO = Path(__file__).resolve().parent.parent
sys.path.insert(0, str(REPO / "host"))
sys.path.insert(0, str(REPO / "scripts"))

from fddproto import drive_session  # noqa: E402
from fddproto.drive_session import Logged  # noqa: E402
from make_recorded_pack import PEAK, POOL_BYTES, RATE, decode, fade, write_wav  # noqa: E402

BLOCK = RATE // 1000  # samples: about 1 ms
BLOCK_S = BLOCK / RATE  # exactly (0.998 ms: over a session, the difference adds up to seconds)
QUIET_BLOCKS = 10  # an onset follows this long under the threshold
DEFAULT_STEP_S = 0.026  # the Feather's: 13 ms STEP pulses, 13 ms apart
LENGTHS = {"spinup": 0.75, "spin_revs": 3, "spindown": 1.4, "insert": 0.45, "eject": 0.45}


@dataclass
class Click:
    t: float  # seconds into the recording
    level: float  # the loudest block in its first 20 ms
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
