MaverickUK/FDDSynthPro/(commit log)

2026-10-22 Scaffold FDDSynthPro: slice 0 listen-only firmware, tests, rig and docs
    Mirrors HDDSynthPro's structure: Arduino-Pico on the BB48, host-side C++
    tests, pytest sim and rig tests with a Greaseweazle as the host, CI, and
    the plan, wiring and bring-up docs.
2026-10-23 Slice 1: head, index and status lines (0.2.0)
    Pure C++ head, spindle and drive model, tested against a virtual
    Greaseweazle that follows its firmware's seek and timing. A bb48_drive
    build puts TRK00, INDEX, WPT and DSKCHG on the SN7407, and rig tests
    cover seeks, sweeps, the status pins and gw rpm.
2026-10-23 Slice 2 track encoder: CRC-16, MFM, IBM track layout, generated disk
    Every track of generated and random 1.44 MB and 720 KB disks matches
    Greaseweazle's encoder cell for cell, and its decoder reads them back.
2026-10-23 Slice 2: RDATA streamer (0.3.0)
    fdd_rdata.pio streams both heads of the cylinder interleaved, choosing
    the head per cell from SIDE1; two DMA channels loop over the buffer and
    the stream restarts at each index pulse. Tested in the PIO simulator,
    including Greaseweazle decoding sectors from the simulated pulse timing.
2026-10-23 Use a Feather RP2040 + Floppy FeatherWing as the rig's host
    Adafruit's Greaseweazle-compatible firmware lets gw drive it: default to
    drive A (its only select, pins 12/16), skip what it can't do, and model
    its seek, step and motor timing as a second virtual host. The input
    pull-ups become a socketed network: 10k for the FeatherWing's 5 V outputs,
    1k for a real PC.
    [config.h, greaseweazle.py, main.cpp, short_test.h, test_drive.cpp, test_slice0.py]
2026-10-23 Slice 3: images on the SD card (0.4.0)
    The drive serves the first 720 KB or 1.44 MB image on the card (SDIO),
    or the generated disk without one. A step-at-a-time cylinder loader
    restarts when the head moves, and RDATA stays released until the buffer
    holds the head's cylinder. A timing simulation checks loads against the
    host's settle time at PC, Greaseweazle and Feather step rates.
2026-10-23 Slice 4: sound events (0.5.0)
    The drive turns motor, step and disk changes into ACT lines for the FDD
    Synth: clicks for single steps, seeks for runs closer than 20 ms, and a
    BUMP when the head hits an end stop, which a listen-only synth can't
    tell from a step. Tested through the drive model with the virtual hosts.
2026-10-23 Add a synthesised stand-in FDD sample pack
    scripts/make_placeholder_samples.py models each sound (motor hum with a
    per-revolution flutter, damped ticks for steps, a 6 ms tick loop for
    seeks, a heavier knock for the stops) and writes samples/Placeholder/,
    until a real drive is recorded.
2026-10-23 Slice 5, part 1: decoding writes
    A data separator (a PLL with Greaseweazle's gains), a field scanner and a
    write interpreter that places sector writes by position and track writes
    by their IDs. Tested with jitter, speed error and precompensation, and
    against tracks from Greaseweazle's encoder.
    [decode_write.cpp, ibm_track.cpp, ibm_track.h, mfm_decode.cpp, mfm_decode.h, test_main.cpp, test_write_decode.cpp, test_write_decode.py]
2026-10-23 Slice 5: writing (0.6.0)
    A PIO program captures WDATA while WGATE is asserted; core 0 decodes each
    burst, places sector writes by position and track writes by their IDs,
    patches the live track and writes the sectors through to the image on
    the SD card. Tested end to end on the Mac: the decoder against
    Greaseweazle's encoder, the capture in the PIO simulator.
2026-10-23 Add the logo to the README, and the stand-in pack's demo
    demo.wav is scripts/make_placeholder_samples.py --demo: a short session
    played with the placeholder samples.
2026-10-23 Add a virtual PC that drives the whole drive end to end
    A BIOS and floppy-controller model runs a DOS-like session against the
    drive model, loader, write path and sound events, with core 0 loading in
    the background: boot, FAT and directory reads, a file across the disk,
    writes read back from the card, and a disk swap, all first time. Core 1's
    RDATA gate and write-capture control move into pure code so the firmware
    and the tests share them.
    [drive.h, machine.h, main.cpp, test_main.cpp, test_virtual_pc.cpp, virtual_hosts.h, virtual_pc.h, write_burst.cpp]
2026-10-23 Swap between the card's images, GoTek style
    Console [ and ] eject the disk, open the previous or next image, load the
    cylinder under the head, retune the PIO data rate if the format changed,
    and insert it. The loader and write path go through a DiskSlot. The
    virtual PC finds each disk's data rate after a change, as a BIOS does,
    and reads and writes across a swap from 1.44 MB to 720 KB and back.
    [cylinder_loader.h, image_list.h, machine.h, main.cpp, rdata_pio.cpp, rdata_pio.h, sd_image.cpp, sd_image.h]
2026-10-23 Add a sample player: sound events to a WAV
    fddproto.player mixes a trace's ACT lines with a sample pack by the
    synth's rules (spin-up into the spin loop, clicks, the seek loop, bumps,
    insert and eject), so the virtual PC's session, or a real drive's log,
    can be heard before the synth exists.
2026-10-23 The FDD Synth plays: a mixer, sample packs and I2S output
    synth.h mixes sound events with a sample pack by the player's rules, and
    matches the Python player sample for sample (now integer and saturating,
    as the firmware is). The drive build loads the first pack under /samples
    on the card into RAM and plays it through a MAX98357A on I2S, mixing on
    core 0 between its slower steps.
2026-10-23 Fix CI: two test files defined different MemorySource classes
    The duplicate was an ODR violation: Clang's link happened to keep one
    consistent class, GCC's mixed the two and read the wrong member, so a
    disk came out write-protected. Removed it, and put each test file's own
    types in an anonymous namespace so it can't recur.
    [test_activity.cpp, test_drive.cpp, test_loader.cpp, test_short_test.cpp, test_synth.cpp, test_track.cpp, test_virtual_pc.cpp, test_write_decode.cpp]
2026-10-23 Stream write captures through a ring; size the sample pool to the pack
    WDATA now goes into a 16 KB ring by endless DMA, and core 0 decodes each
    burst in 2 KB chunks as it arrives, with audio served between chunks, in
    place of an 80 KB buffer per burst. An overrun drops the burst rather
    than decoding overwritten bytes. The sample pool is one allocation sized
    to the pack. Static RAM in the drive build falls from 85% to 41%.
2026-10-23 Design the front panel: OLED screens and encoder controls
    A UI model (encoder turn and press, action press and hold) and seven
    128x64 screens drawn on HDDSynth_Native's canvas and font: home with a
    spinning disk and the head across 80 cylinders, the disk list, a disk
    change, volume, a head trace, sounds and stats. Host tests cover the
    controls and render every screen to docs/oled; scripts/build_panel_page.py
    builds an interactive page from the same frames.
2026-10-23 Add a hardware pack: parts list, wiring diagram, board plan
    docs/parts.md lists every part with UK supplier links. docs/wiring.html
    is an interactive pin-to-pin diagram with a soldering checklist for the
    floppy header, SN7407, pull-ups, SD card, amp and the planned front
    panel, and a zone plan for the Perma-Proto. The panel's pins are
    reserved in config.h, with a test that no GPIO is used twice. The input
    pull-ups become an 11-pin SIP network (ten resistors for ten inputs).
2026-10-23 Make lost writes visible: card first, then write-protect
    Each written sector goes to the card first and into the live track only
    if the card took it, so a verifying host reads back the old data. After
    any lost write (a card error or an overrun) the drive reports
    write-protect until the disk is inserted again, so the host's next write
    fails visibly. Noise and damaged-write tests show the decoder stores
    exactly the right sector or nothing.
    [drive.h, machine.h, main.cpp, test_virtual_pc.cpp, test_write_decode.cpp, write_burst.cpp, write_burst.h]
2026-10-23 Run a real DOS disk through the whole drive
    mtools builds a FAT12 disk (a volume label, a fragmented file, a
    subdirectory); the virtual PC mounts it through the drive with a minimal
    DOS, reads every file and writes a new one; then fsck.fat finds it
    consistent and mtools reads every file back. 1.44 MB, 720 KB, and a file
    across tracks and heads. CI installs mtools and dosfstools.
2026-10-23 Faster CI: parallel jobs, incremental C++ builds, sampled track checks
    - test/native.mk builds the C++ tests and tools in parallel, rebuilding
    only what changed; one binary per sanitizer setting.
    - CI runs the firmware build and the tests as separate jobs side by side.
    The tests job caches pip and fetches only pioasm, not PlatformIO.
    - The Greaseweazle comparison checks a spread of tracks by default; all
    160 on tags, on a manual run, or with FDDPRO_FULL_TRACKS=1.
2026-10-23 Wire up the front panel: OLED, encoder and action button (0.7.0)
    - src/panel.*: the SSD1306 on I2C1 (the BB48's Qwiic socket), the encoder
    on interrupts and the action button, on core 0. Frames go into the I2C
    FIFO a few bytes per loop pass, so they never block the loader (15 ms
    settle) or the audio queue.
    - controls.h (pins to ui::Inputs) and ssd1306.h (a frame's bus bytes):
    pure and host-tested.
    - Mixer::setVolume: after the saturating mix, squared, gliding over
    12 ms; unity by default, so the player comparison still holds.
    - main.cpp fills ui::Status from the drive and acts on the panel's
    swap, eject and volume requests. Console `s` adds the panel's stats.
    - Docs: wiring, part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
    [config.h, controls.h, main.cpp, panel.cpp, panel.h, screens.cpp, synth.cpp, synth.h]
2026-10-23 Fix the code review's findings: capture race, swap failures, panel
    - CaptureStream abandons a burst a quarter ring before the DMA could lap
    it, rather than reading bytes being overwritten (new test).
    - A swap to an image that won't open puts the old one back, reopened;
    if neither opens, the drive stays empty instead of serving a closed file.
    - No eject/insert while a swap runs; a panel choice during a console
    swap waits instead of being dropped.
    - panel::begin runs before the drive starts.
    - short_test names the panel and amp pins; CLAUDE.md's volume note.
    [main.cpp, short_test.cpp, test_write_decode.cpp, write_burst.h]
2026-10-23 Add a showreel: the panel, screens and sound over a virtual PC session
    - test/tools/showreel.cpp: a virtual PC uses a real FAT12 disk while
    scripted inputs work the front panel; the real screens every 100 ms
    (via a new Machine::on_tick hook) and the real mixer, volume included.
    - scripts/make_showreel.py: builds the disk with mtools, lays out the
    OLED, controls, captions and the PC's log with Pillow, encodes with
    ffmpeg to media/showreel.mp4.
    - Fix: the swap screen named the new disk while the old one ejected.
    [machine.h, make_showreel.py, screens.cpp, showreel.cpp, test_ui.cpp]
2026-10-23 Showreel: show each sound event and the output level, louder audio
    - showreel writes sounds.txt: every event the mixer was given, timed.
    - The video adds an output meter and a lane naming each sample as it
    fires; the audio is 44.1 kHz stereo AAC for wider player support.
    - The volume goes to 100% after power-on and dips only to 60%.
2026-10-23 Add the showreel to the README
    The video (media/showreel.mp4, 2 MB) and a poster frame with a play
    button, which links to the video; make_showreel.py now makes both.
2026-10-23 Add a sample pack cut from a real drive's recording
    - scripts/make_recorded_pack.py cuts samples/Recorded from
    media/FDDSynth_ExampleBehaviours.m4a: spinup, spin (4 revolutions,
    joined), spindown, step (the most typical of a 79-step sweep), seek
    (20 steps 10 ms apart, looped) and bump (the knock at the end stop).
    Where each comes from is measured and noted in the script.
    - The mixer-vs-player comparison runs on both packs; new tests for the
    pack's format, size and loops.
    - make_showreel.py --pack renders the showreel with any pack.
2026-10-23 Showreel: the recorded pack, "FDD Synth Pro", an audible soundtrack
    - The showreel uses samples/Recorded by default (--pack for another).
    - The video calls the project FDD Synth Pro.
    - The soundtrack gets one gain so its loudest moment is at -1 dBFS: a
    real drive is quiet. The meter shows the level heard.
2026-10-23 README: pin the showreel link to the commit with the new video
    jsDelivr caches @main for hours; a commit link serves the file at once.
2026-10-23 Remember the disk, pack and volume; choose the pack on the panel (0.8.0)
    - settings.*: /FDDSYNTH.CFG, plain text, by name; written 3 s after the
    last change and only while the drive is idle. A missing or damaged file
    falls back to the defaults (fuzzed in the tests).
    - The Sounds screen's press opens the pack list (every folder under
    /samples); a choice loads once the drive is idle. loadPack frees the
    last pack first; Mixer::reset drops what pointed into it, keeping a
    running motor's spin. The mixer now hears every event, pack or not.
    - Console k: the next pack. audio::setRate for packs at another rate.
    - PackList beside ImageList; find() by name on both.
    - Docs: bring-up checks, ac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
    [audio.cpp, audio.h, image_list.h, main.cpp, screens.cpp, screens.h, sd_image.cpp, sd_image.h]
2026-10-23 Test the panel's cost on core 0 against the settle time (0.8.1)
    - Machine models panel frames on core 0 (Core0Costs::draw_us, 2 ms,
    pessimistic), drifting against the rotation as on the board, and
    reports the slowest cylinder-ready after a step and core 0's longest
    step.
    - Tests: a seek session (random and single steps) stays within the 15 ms
    settle with the panel drawing; the frame rate holds; the worst case,
    a frame starting as the head steps, is built on purpose: frames up to
    4 ms keep every settle time.
    - Firmware: no frame starts while a cylinder is loading
    (CylinderLoader::loading()).
    - Bring-up: draw_us_max must stay under 4000.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
    [cylinder_loader.h, machine.h, main.cpp, panel.cpp, panel.h, test_virtual_pc.cpp, version.h]
2026-10-27 BB48R pin map, disk images in PSRAM, and builds without the SN7407 (0.9.0, 0.10.0)
    0.9.0: the pin map moves to the BB48R (the BB48 with PSRAM and a microSD
    slot), whose PSRAM select and SD card use GPIO 8-11 and 24. Inputs move to
    GPIO 12-21, outputs to 4-7 and 22, the panel to 32-35; the SD card is read
    through the board's own slot on SPI1. The solder-bridge test drives only
    the floppy pins.
    0.10.0: each image is copied into PSRAM before the disk goes in (power-on,
    and a swap's ejected pause), so track reads are memory copies and the card
    can run at the SD spec's 25 MHz. Writes go to the card first, then the
    cache. PSRAM is read through its uncached alias so core 1's code stays in
    the XIP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
    [config.h, fdd_signals.h, image_cache.cpp, image_cache.h, machine.h, main.cpp, rdata_pio.cpp]
2026-10-27 Rig: work with the Feather host's firmware
    - gw reset hangs on Adafruit's Greaseweazle-compatible firmware (it answers
    the delays request with 12 bytes, gw waits for 16): fddproto.gw_reset
    sends the reset command alone, and Greaseweazle.reset() uses it.
    - The capture waited for a quiet trace from the last line printed, so it
    stopped before a long run of steps (printed as one line when it ends)
    arrived. It now counts the quiet from when the action returns.
    - Slice 0 follows what the Feather really does: microsecond glitches at
    the start of every command (Trace.held_signals ignores them), a refused
    drive B that still exits 0, DIR and WDATA left as levels at idle, the
    motor left o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
    [drive_log.py, greaseweazle.py, gw_reset.py, test_gw_tools.py, test_slice0.py, test_trace_parse.py, trace.py]
2026-10-27 Carrier board for the BB48R, for JLCPCB assembly
    A KiCad 10 project in hardware/: the BB48R plugs onto it (DNP), with the
    SN7407 (SOIC-14), 10k pull-ups and a jumper-switched 1k bank for a real
    PC (0402), the floppy box header and headers for the panel and amp, all
    with LCSC part numbers. It has the HDD Synth MK5's outline, mounting holes
    and speaker grille, clear of Pimoroni's 40 mm speaker.
    The schematic, board and JLCPCB files are generated (make_schematic.py,
    make_pcb.py with its own rip-up-and-reroute router, make_jlc.py) and
    checked by build.sh: ERC and DRC clean, every pad connected, schematic
    parity. test_carrier_schematic.py checks the netlist against config.h.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
    [bom.csv, fddsynthpro_carrier.kicad_pcb, fddsynthpro_carrier.kicad_sch, positions.csv]
2026-10-29 Drive select as a real drive's jumpers: PC A/B on either cable, Shugart DS0-DS2 (0.11.0)
2026-10-29 Two drives on one cable: A and B, each with its own disk, head and buffer (0.12.0)
2026-10-29 Disk formats: PC sizes from 160 KB to 1.68 MB, 360 RPM, and GoTek's IMG.CFG (0.13.0)
2026-10-29 The Amiga: ADF images, AmigaDOS tracks and writes, DF0/DF1, and pin 2 after a rework (0.14.0)
    [amiga_track.cpp, amiga_track.h, build_track.cpp, bus.cpp, bus.h, config.h, drive.cpp, drive.h]
2026-10-29 Ignore hand-made KiCad exports and the invalid reference traces
2026-10-29 A fixed startup image: image= set by hand, last= remembered (0.16.0)
    [main.cpp, settings.cpp, settings.h, test_settings.cpp, version.h]
2026-10-29 A sample FDDSYNTH.CFG on the welcome disk; read settings files up to 4 KB (0.16.1)
    [FDDSYNTH.CFG]
2026-11-04 Rig tests on the Feather host: pin reads, its fast clock, capture tails
    - `gw pin get` takes the pin straight after the sub-action; the wrapper put
    it after the options, so every read came back empty. Slice 1 skips pins
    the Feather can't read (it answers only pin 26).
    - The Feather's clock runs 0.4-0.6% fast against the 24 MHz it reports, so
    it measures 300 RPM as 298.3-298.7: `rpm_tolerance` gives it +/-3.
    - `run_dir` holds `gw` so its transcript can still be saved at teardown.
    - Slice 4 waits for the last command's tail before marking a capture.
    [greaseweazle.py, test_gw_tools.py, test_slice1.py, test_slice4.py]
2026-11-04 Encode a track in 3 ms, not 26; ignore the Feather's motor glitches (0.19.0)
    - MFM encoding, CRC-16 and the head interleave use lookup tables kept in
    RAM; the hot loops run from RAM (RAM_FUNC, src/ram_func.h) with their
    helpers forced inline, and each field is encoded and checksummed in one
    pass. A cylinder now loads in 11.6 ms at worst on the rig, inside the
    host's 15 ms settle time.
    - Console `t` times a loader step in its parts, `z` zeroes the loader's
    timings; `s` prints their means.
    - The sound events hear the motor only once its line has held for 1 ms:
    the Feather pulses it for microseconds at the start of every command.
    The virtual Feather now does the same (`commandStar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
    [activity.cpp, activity.h, crc16.h, ibm_track.cpp, machine.h, main.cpp, mfm.h, mfm_decode.cpp]
2026-11-05 Settings: device0/device1 and last0/last1, as HDDSynthPro (0.20.0)
    Each drive's disk to start with is now device0/device1 (was image/image2),
    and the disk that was in last0/last1 (was last/last2). Drives count from 0,
    as HDDSynthPro's devices and Shugart's DS0. The old names are still read
    and written back under the new ones; with both, the new name counts.
    [FDDSYNTH.CFG]
2026-11-05 First run on a BB48R: writes keep up, HFE loads in 6 s, Amiga prep (0.21.0)
    On the board, with PSRAM and the card, against the Feather: the solder-
    bridge test, slices 0-5 (and 100 written tracks with no mismatch), swaps
    round six images, and an HFE image read back byte for byte.
    - The write decoder managed 200 KB/s on the board against an HD write's
    370, so every HD write overran. BurstWriter::feed now runs from RAM with
    the separator and scanners inlined, a whole interval at a time
    (FieldScanner::addInterval, amiga::SectorScanner::addInterval): 1,650
    KB/s. Tests hold both to the per-cell paths, with a hand-built case each
    for a sync on the boundary where only the right order fin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
    [amiga_track.h, hfe.cpp, image_cache.h, machine.h, main.cpp, mfm.h, mfm_decode.cpp, mfm_decode.h]
2026-11-05 Settings over the console, a PSRAM cache-line fix, Amiga tracks proved on the rig (0.22.0)
    - Console e, then key=value and Enter: one setting into /FDDSYNTH.CFG,
    written at once when the drive is idle, the file printed back; ! restarts
    with it (as HDDSynthPro's E and !). settings::set shares parse's line
    handling and refuses unknown keys and bad values. DriveLog gains
    set_setting and restart.
    - An image could start with 4 wrong bytes after a restart: pmalloc's
    bookkeeping, written through the XIP cache, shared a cache line with the
    image's start (written uncached), and the line's write-back put back what
    PSRAM held before. Reproduced on the rig after serving a DOS disk; the
    i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
    [drive_log.py, main.cpp, settings.cpp, settings.h, test_amiga_rig.py, test_settings.cpp, version.h]
2026-11-05 Docs: real-computer test steps (PC, Amiga), the plan at 0.22.0
    docs/hardware-tests.md: setup, steps with what to expect, checks afterwards
    and what to look at when a step fails, for a real PC and a real Amiga
    (after the pin 2 rework). The plan's status now reflects the BB48R rig.
2026-11-05 Core 1's own stack, encode once per write, HFE writes, formats and soak tests (0.23.0)
    - Core 0's start-up overran its 4 KB stack into core 1's (IMG.CFG parsing),
    so core 1 never reached loop1(). Core 1 now has its own 8 KB stack and
    img_cfg::find keeps its parse state off the stack. `s` shows core1 and
    core0_stack.
    - A burst stores its sectors, then encodes the head once (65 ms -> 12 ms a
    track), so the audio no longer drops out on every track write;
    BurstWriter::between_writes services the audio between card writes.
    - HFE track writes go to the card 16 blocks at a time (816 ms -> 84 ms).
    - finish_us_mean in `s`.
    - Rig tests: -m formats (six formats incl. FM from IMG.CFG), -m soak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
    [cylinder_loader.cpp, cylinder_loader.h, hfe.cpp, img_cfg.cpp, main.cpp, test_formats.py, test_hfe.cpp, test_slice5.py]
2026-11-05 A louder Recorded pack, HFE loads in 3.9 s, HFE writes spare the audio (0.23.1)
    - make_recorded_pack.py: one gain for the clicks and motor (a step 6 dB
    under full scale), the bump scaled on its own; about 9 dB louder. The
    showreel is re-rendered with it.
    - The cache fills a cylinder at a time (TrackSource::readCylinder); an HFE
    file is read once for both heads, and its cells are staged before going
    into PSRAM: 5.8 s -> 3.9 s for an HD HFE.
    - HFE track writes go to the card in 4 KB pieces with the audio serviced
    between them.
    - audio_gap_us_max in `s`; the soak logs it.
2026-11-05 HFE cylinder loads give the audio its turns; the plan at 0.23.3
    - hfe::Disk::between_reads, set through sd_image::setBetweenReads to the
    audio: an HD HFE cylinder is about 50 ms of card reads, longer than the
    46 ms audio queue, so a swap to one could drop the sound out.
    - docs/plan.md: where it stands at 0.23.3.
    [hfe.cpp, hfe.h, main.cpp, sd_image.cpp, sd_image.h, test_hfe.cpp, version.h]
2026-11-05 A swap to an HFE image gives the audio its turns (0.23.4)
    The swap's last step loaded the cylinder under the head, both HFE heads
    (about 27 ms each), with no audio service: a 55 ms gap against the 46 ms
    queue. The loader's steps now have the audio between them, at power-on too.
    [main.cpp, version.h]
2026-11-05 A 32 KB capture ring rides out card pauses; the virtual PC times writes (0.23.6)
    The card now and then holds a write or sync for 50-60 ms. The virtual PC,
    now able to time the write path (decode rate, a burst's finish, card
    stalls), shows a PC writing a track's sectors one after another losing the
    write to such a pause with the 16 KB ring (33 ms of slack): an overrun, then
    write-protect. 32 KB is the DMA's largest ring wrap; with the guard capped
    at 4 KB core 0 can fall 77 ms behind, and stalls up to 70 ms lose nothing.
    [config.h, machine.h, main.cpp, test_virtual_pc.cpp, version.h, wdata_pio.h, write_burst.h]
2026-11-05 Tools for recording a real drive into a sample pack
    scripts/record_drive.py drives a real drive through every sound with gw
    (single steps across the disk, seeks of 2-78 steps each way, bumps if the
    firmware will, spins, reads, writes, prompted inserts and ejects), records
    the mic with ffmpeg and logs when each action ran. scripts/make_drive_pack.py
    finds the clicks, the offset between recording and log, the step rate and
    the revolution, and cuts a pack that fits the 160 KB pool, keeping every
    seek whole for rate-aware seek sounds. test_drive_pack.py runs it on a
    simulated session. docs/recording.md has the steps.
2026-11-05 scripts/check_log.py: what a real computer's session log needs a look at
    Restarts the log didn't ask for (from the board's clock going back, as boot
    messages are lost in the reconnect), write faults, steps past either end of
    the disk, lost trace events and non-zero fault counters in the last s line;
    and a summary of the session: select lines, step rate, writes, disk changes.
    Tried on the soak's serial logs (clean, every restart asked for).
    [check_log.py, test_check_log.py]
2026-11-06 Console keys work the front panel: , . < > (0.23.7)
    The action button, an encoder press and turns go to the panel's model as
    the controls' inputs do, and print the screen they lead to, so a script
    can step through the screens and set the volume as the encoder does.
2026-11-06 CLAUDE.md: the Feather can hold select and motor on after a seek with the motor
2026-11-06 Recording a real drive: wait for the mic, --check, --borrow; the RealDrive pack
    record_drive.py waits until the microphone's audio is arriving (the
    iPhone's Continuity mic took 39 s) and saves the offset for the cutter;
    --check spins the motor for 15 s and says whether the hum held. The
    cutter's click threshold stays above the motor's knock once a
    revolution, inserts and ejects no longer set the pack's gain, and
    --borrow fills sounds the recording lacks from another pack.
    samples/RealDrive: steps, spin, inserts and ejects from a real 3.5" drive
    on the Feather, recorded with Voice Memos (the Continuity mic drops about
    12% of its audio); seek and bump borrowed from Recorded.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
    [make_drive_pack.py, record_drive.py]
2026-11-06 Steps from STEP's edge latch: a real PC's short pulses aren't missed (0.23.8)
    On the Evesham, copying RANDOM.BIN failed with Sector Not Found at
    cylinder 9: the PC's step to 10 fell inside core 1's pass that restarts
    the stream at the index, a few-microsecond pulse no sample saw. Every
    falling edge on STEP is now counted from the GPIO block's raw interrupt
    status, exactly once. The copy and FC /B then passed.
    [drive.cpp, drive.h, main.cpp, test_drive.cpp, version.h]
2026-11-06 A switched-off computer's lines, all low, are taken as released (0.23.9)
    With the Evesham off and the drive on USB, every input read low (the
    PC's unpowered chips clamp them), so the drive saw itself selected with
    the motor on and played its spin. No running host asserts every line at
    once: fdd::hostOff takes that as the host switched off and core 1
    treats the lines as released. # host off / # host on, and host= in s.
2026-11-06 RealDrive's seek from a real drive in a PC; scripts/cut_seek.py
    The Evesham's BIOS seeks at 5.05 ms a step, where the Feather steps every
    26 ms and the pack borrowed Recorded's seek. cut_seek.py loops 40 whole
    steps from the median full-stroke seek of a Voice Memo of FDDBench, at the
    level that keeps it against the pack's step as the room had it (a seek
    peaks 6.5 dB over a single step), and shortens the spin-down by 46 samples
    to keep the pack in the 160 KB sample pool.
    The memo gave nothing else: inside the PC its noise hides the motor, and
    the BIOS's recalibrate never knocks. docs/recording.md says so, and how to
    find the windows from FDDBENCH.LOG.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
    [cut_seek.py, test_cut_seek.py]
2026-11-06 Showing a write never tears the sector being read: FORMAT verifies first time (0.23.10)
    On the Evesham, DOS FORMAT's first verify of 148 tracks in 160 failed and
    it formatted each again. A write is shown by re-encoding the head and
    copying it over the buffer the DMA streams; the copy overtook the head in
    the middle of the sector being verified, which read half old and half new.
    A format changes every sector, so the verify nearly always hit one.
    The loader now starts the copy at the word the DMA fetches next
    (StreamPosition; rdata_pio::nextWord reads the channel's read address), so
    it stays ahead of the head, and holds back the run of changed words the
    head is in until it has passed (service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
    [cylinder_loader.cpp, cylinder_loader.h, machine.h, main.cpp, rdata_pio.cpp, rdata_pio.h, test_loader.cpp, test_virtual_pc.cpp]
2026-11-06 docs: the Evesham's afternoon (the real drive, FORMAT, the timer) and the start-up trouble
2026-11-06 docs: the timer's cause is an inference until FDDBench 0.4.1 runs there
2026-11-06 An Amiga's bus at hardware speed: edge samplers and an output gate in PIO (0.24.0)
    An A1200 selects its drive for 4 us per ID bit and about 20 us around each
    step, changing DIR with the select. Core 1's once-a-pass sample garbled the
    ID (Kickstart never booted DF0), missed track 0 (the head knocked at the
    stop) and lost steps (cylinder 32 or 35 for 40: NDOS).
    fdd_edge samples the ten inputs within two cycles of STEP or the select
    falling (Drive::onStepEdge, onSelectEdge); fdd_gate (fdd_gate_od for the
    direct builds) puts Drive::outputsSelected on the cable only while the
    select is asserted. One Amiga drive only; the gate sits in the PIO block
    the streamer doesn't use, since its OUT range co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
    [amiga_pio.cpp, amiga_pio.h, drive.cpp, drive.h, main.cpp, test_amiga.cpp, test_amiga_pio_sim.py, version.h]
2026-11-06 Console j: straight to an image by name; l lists them
    j, then a name (robocod, or ROBOCOD.ADF, any case) and Enter, swaps to
    that image at once: one eject and insert, not a ] for every image on the
    way (ImageList::match: the whole name, or the name less its extension,
    refusing one that's two images'). l lists the card's images.
    [image_list.h, main.cpp, test_virtual_pc.cpp]
2026-11-06 A step takes DIR as STEP rises: a loader may set DIR in the same write
    fdd_step samples the inputs as STEP falls (the select) and as it rises
    (DIR), as a drive takes a step at the pulse's end. Tests: the simulator
    with DIR changing in the same cycle as STEP falls, and the model with a
    loader doing so (wrong way at the fall, right at the rise).
    [amiga_pio.cpp, amiga_pio.h, test_amiga.cpp, test_amiga_pio_sim.py]
2026-11-06 docs: the pin 2 rework in detail (lift pin 13 from the pour; 10k on GPIO 23), and why an Amiga needs it
2026-11-06 The FDD Synth Pro logo on the OLED for a second at power-on
    scripts/make_splash.py makes src/splash_logo.h from media/FDDSynthPro.png
    (cropped, scaled to 128x64, thresholded: dithering lost the detail).
    ui::Screen::Splash holds it for SPLASH_MS from Model::showSplash, which
    panel::begin calls and draws at once, so it shows while the card mounts
    and the disk caches; a turn or press skips it. Tests: the timing, the skip,
    and the rendered screen (docs/oled/splash.png).
    [make_splash.py, panel.cpp, screens.cpp, splash_logo.h, test_ui.cpp, ui.cpp, ui.h]
